kubatyszko/SD-SCSI/SD-SCSI.pdf

# SD-SCSI-50-header.pcb

# 1. Table of Contents (This Page) Created on Wed Jul 9 09:12:22 2014

# 2. component 3. solder 4. plated-drill 5. componentmask 6. soldermask 7. topsilk 8. bottomsilk 9. toppaste 10. bottompaste 11. topassembly 12. bottomassembly 13. fab

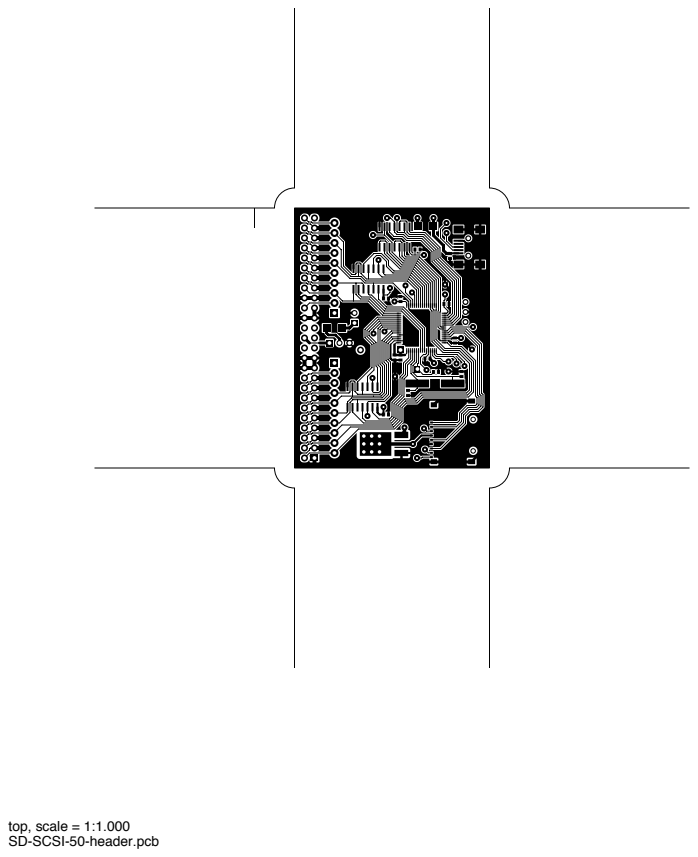
[picture p1: page 2]
top, scale = 1:1.000

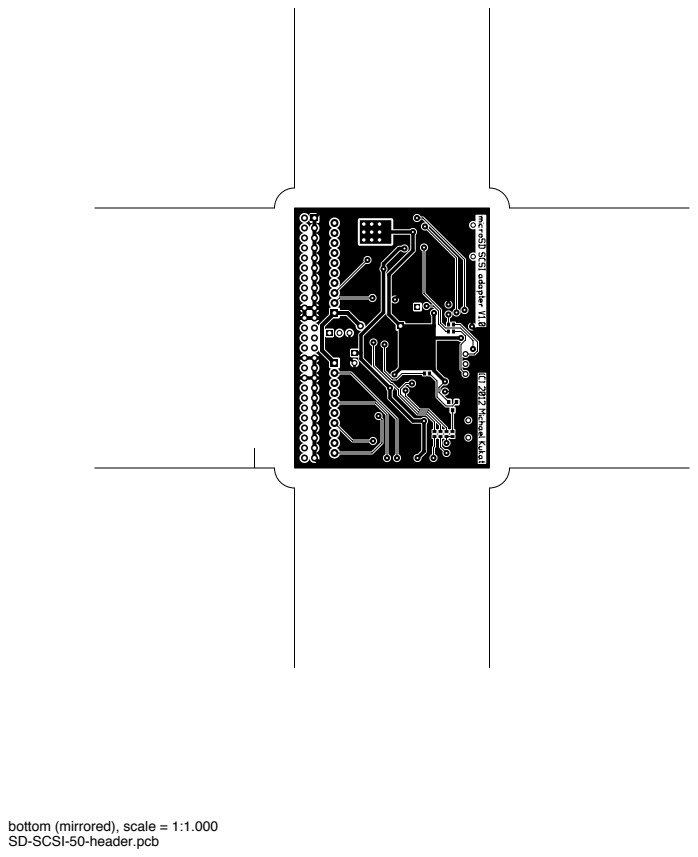
[picture p2: page 3]

bottom (mirrored), scale = 1:1.000

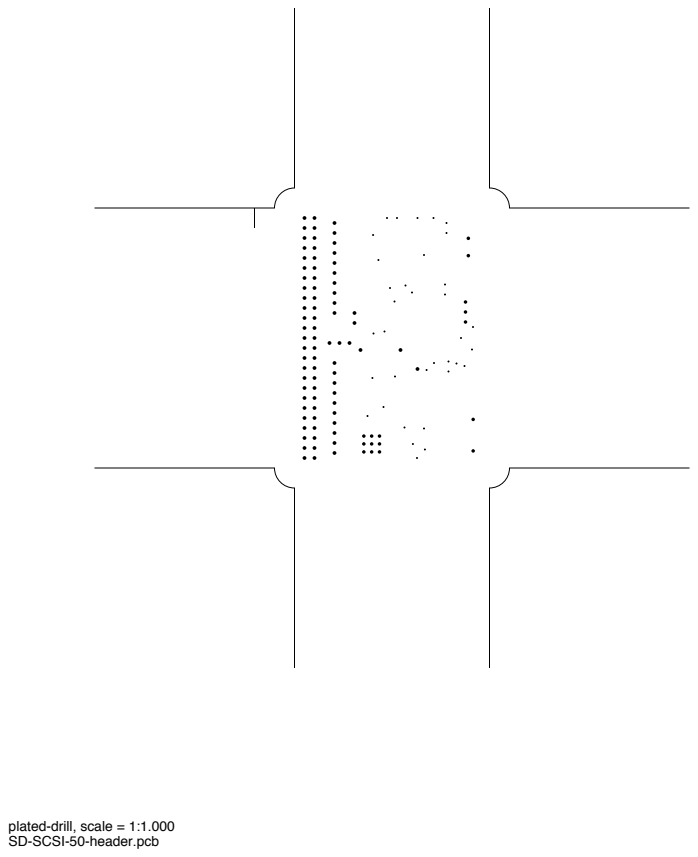
[picture p3: page 4]

plated-drill, scale = 1:1.000

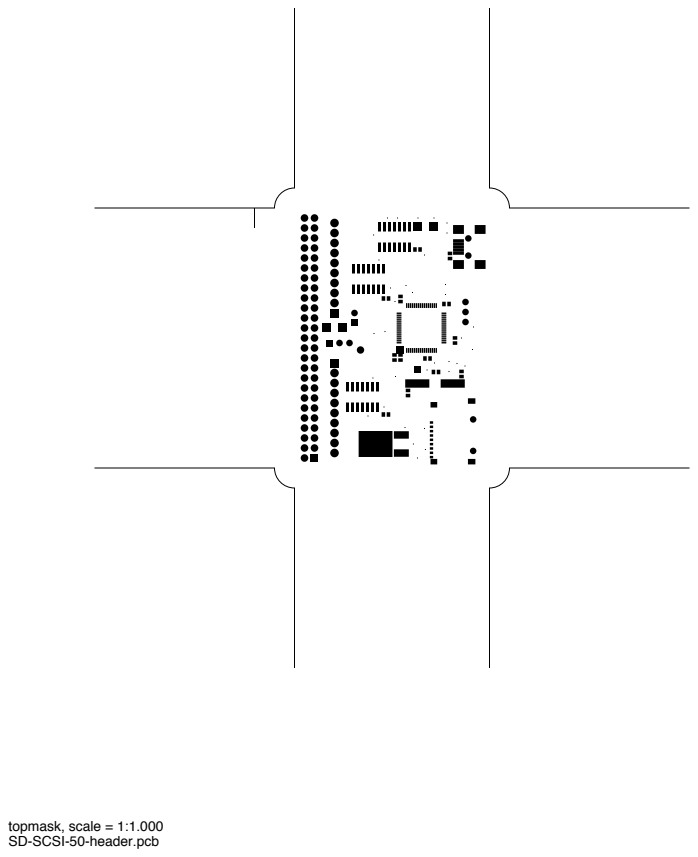
[picture p4: page 5]
topmask, scale = 1:1.000

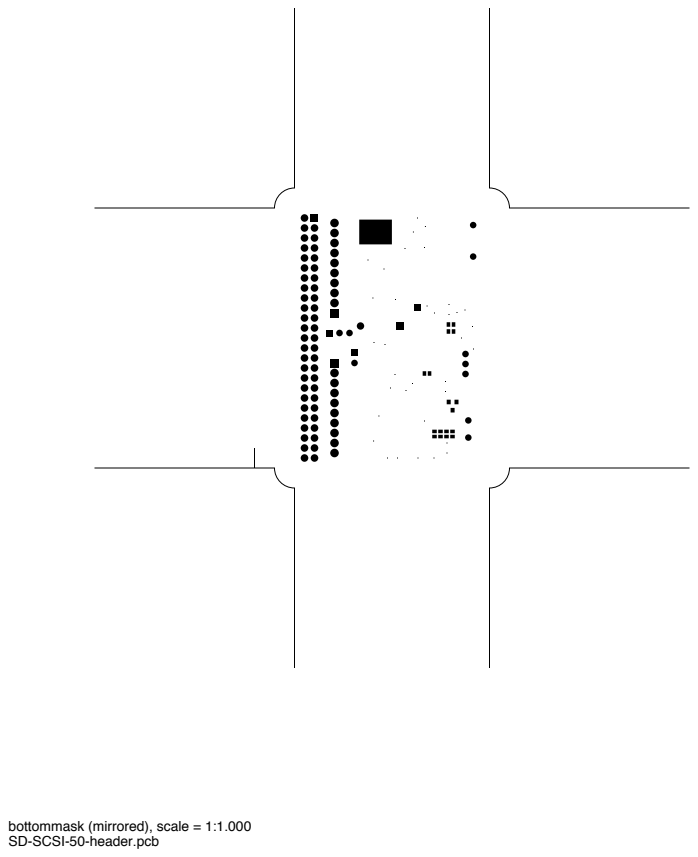
[picture p5: page 6]

bottommask (mirrored), scale = 1:1.000

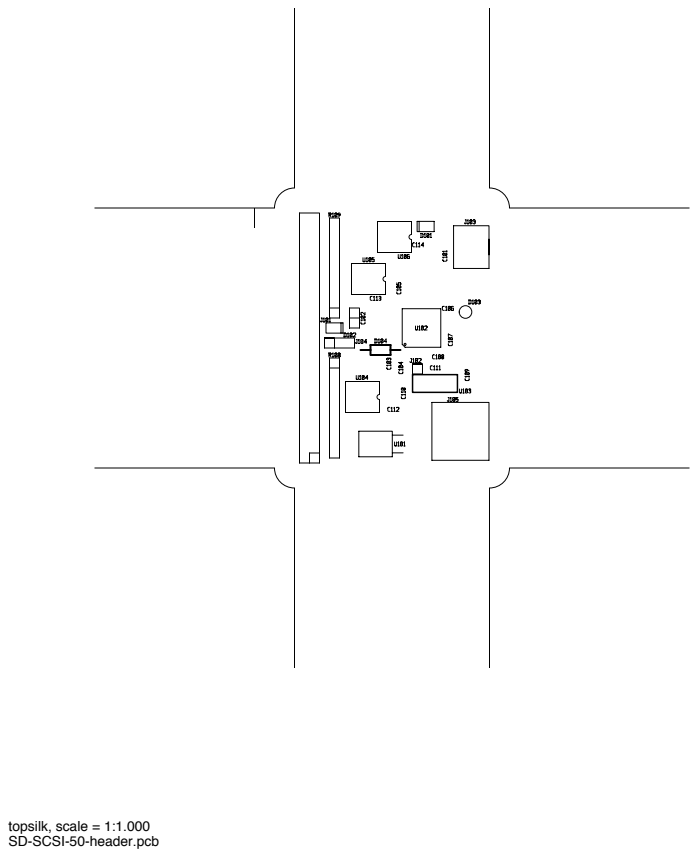
[picture p6: page 7]
topsilk, scale = 1:1.000

# bottomsilk (mirrored), scale = 1:1.000

# toppaste, scale = 1:1.000

# bottompaste (mirrored), scale = 1:1.000

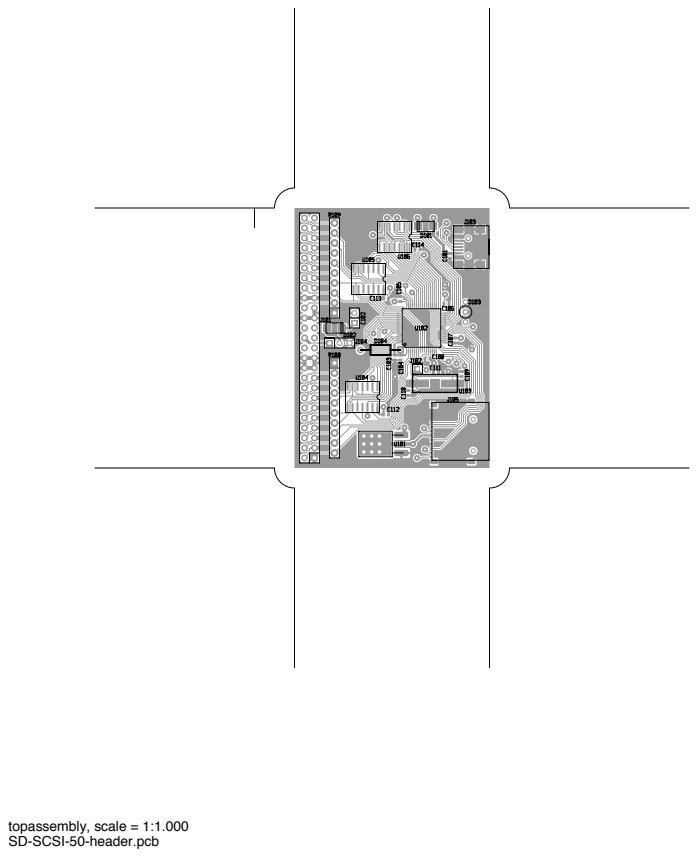
[picture p7: page 11]
topassembly, scale = 1:1.000

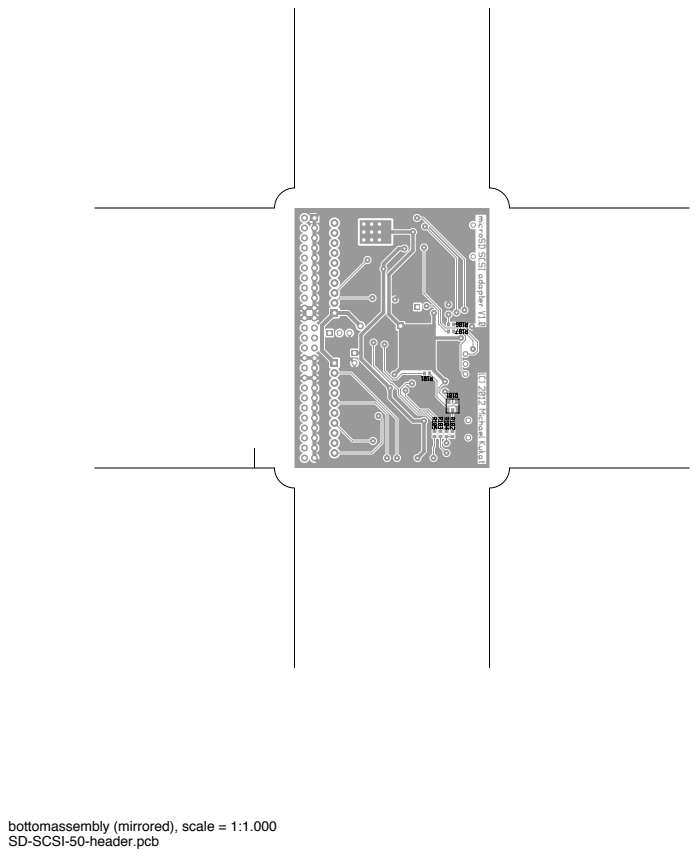
[picture p8: page 12]

bottomassembly (mirrored), scale = 1:1.000

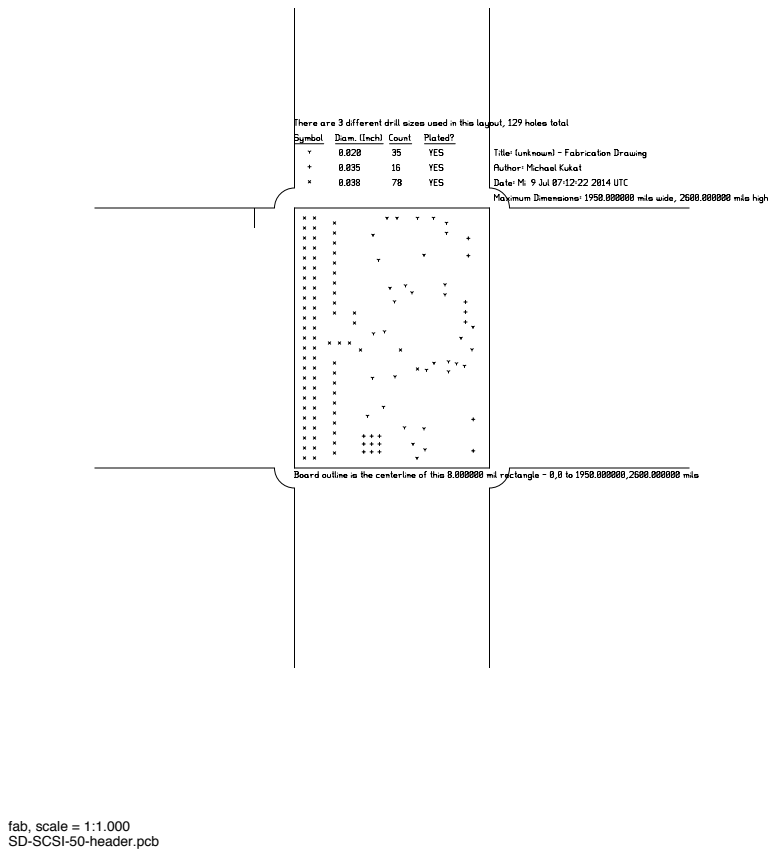
[picture p9: page 13]
fab, scale = 1:1.000

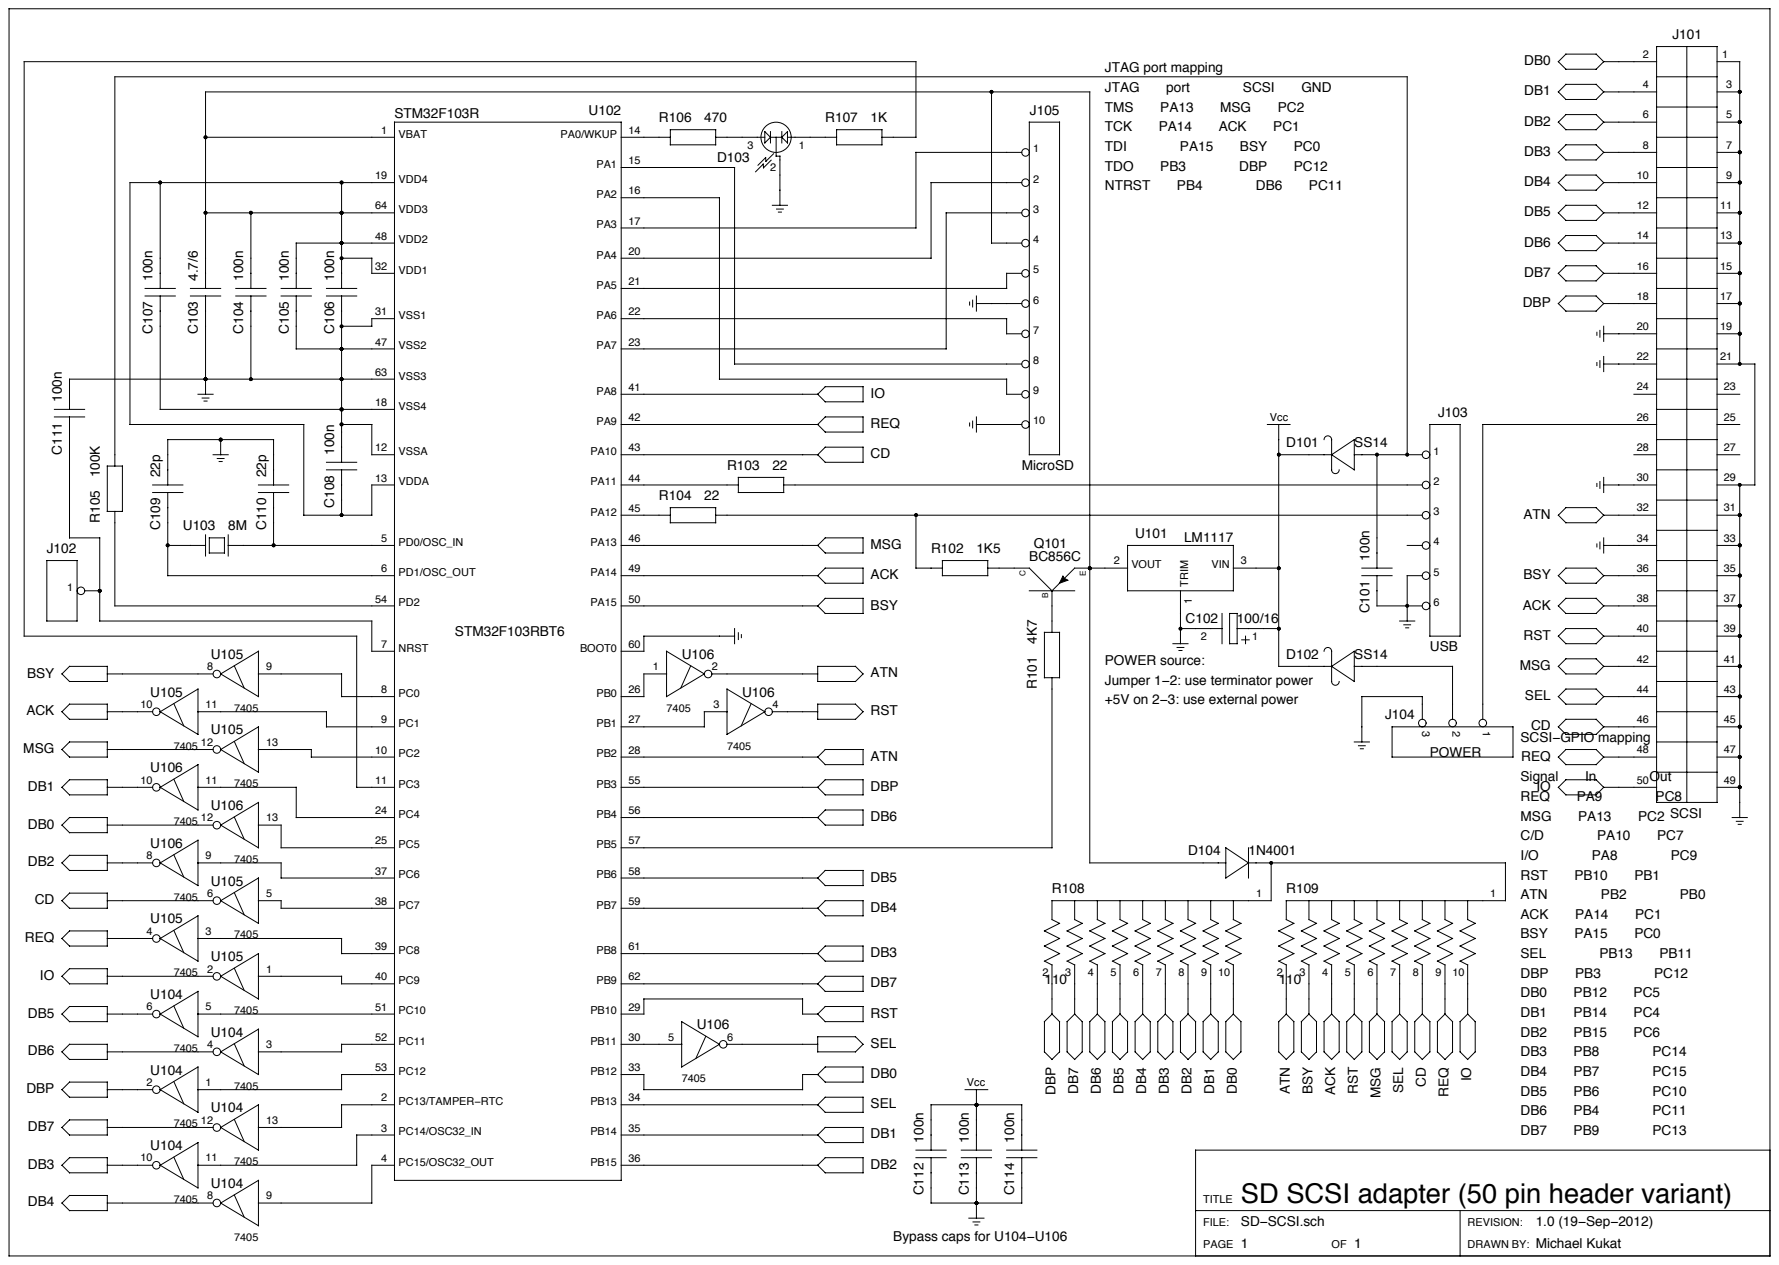
[picture p10: page 14]

POWER source:
Jumper 1−2: use terminator power
+5V on 2−3: use external power

SD SCSI adapter (50 pin header variant)
