kubatyszko/SD-SCSI/(list of files, drawings)

Other design files:
SD-SCSI-50-header.pcb
