kubatyszko/SD-SCSI/(commit log)

2014-07-09 Added hardware documentation
    [SD-SCSI-50-header.pcb, SD-SCSI-50-header.sch, SD-SCSI.cfg]
2014-07-14 Added firmware files (DFU loader broken currently)
